mirelatomazini/InstrumentacaoBiomed/instrumentacao_projeto/imagem1_real.jpeg

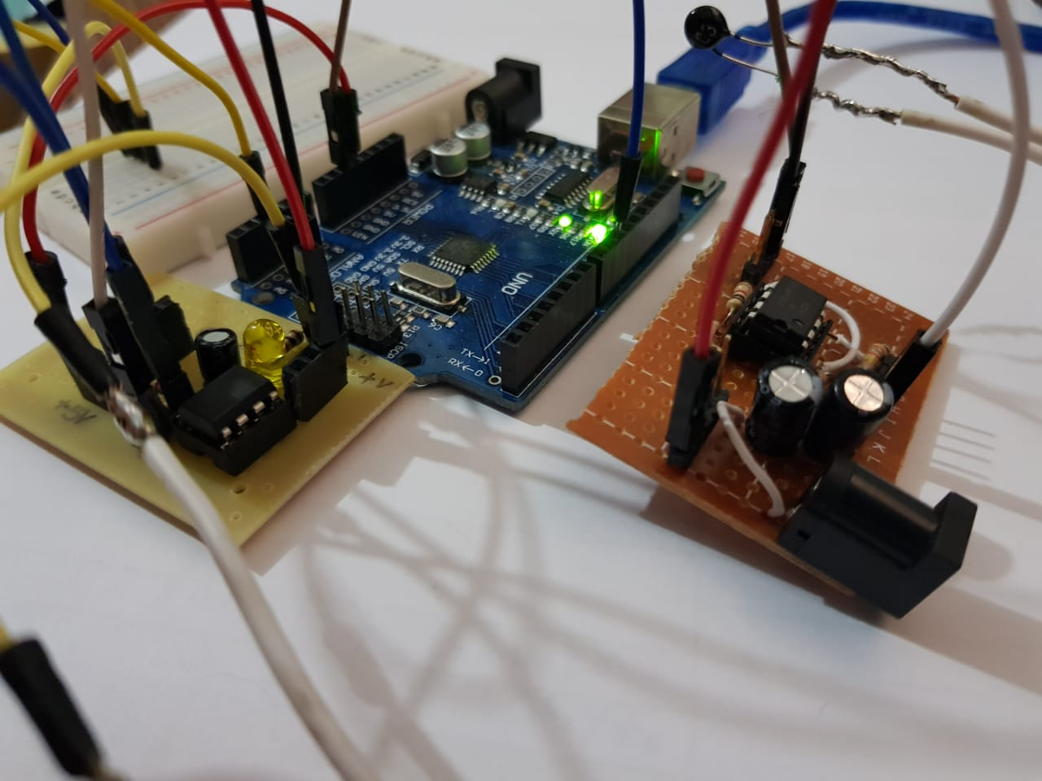
instrumentacao_projeto/imagem1_real.jpeg
