mirelatomazini/InstrumentacaoBiomed/instrumentacao_potenciometro/instrumentacao_potenciometro_plotterserial.jpeg

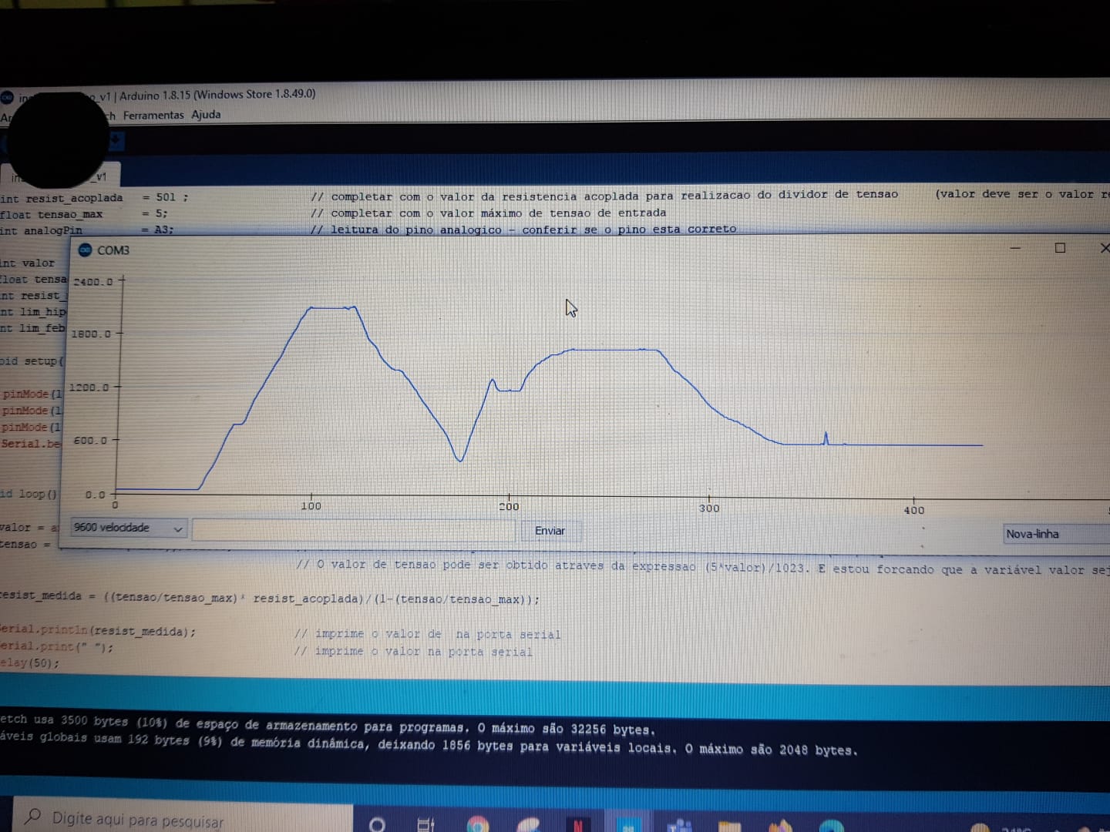
instrumentacao_potenciometro/instrumentacao_potenciometro_plotterserial.jpeg
