mirelatomazini/InstrumentacaoBiomed/instrumentacao_projeto/InstrumentacaoApresentacaoProjeto.pdf

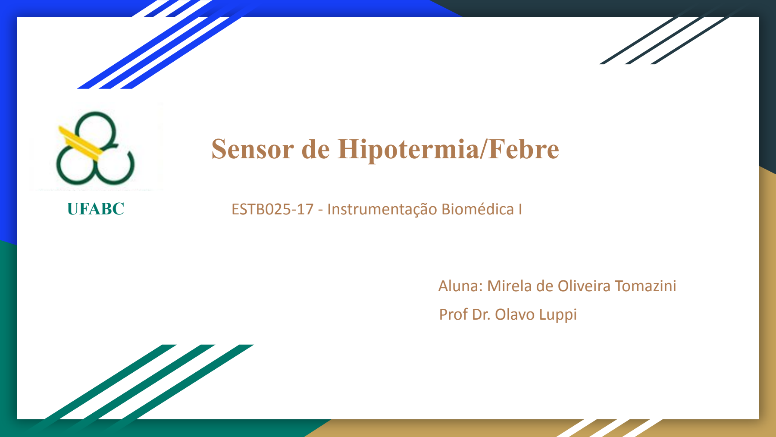
[picture p17: figure]
Sensor de Hipotermia/Febre; Aluna: Mirela de Oliveira Tomazini; ESTB025-17 - Instrumentação Biomédica I; Prof Dr. Olavo Luppi; UFABC

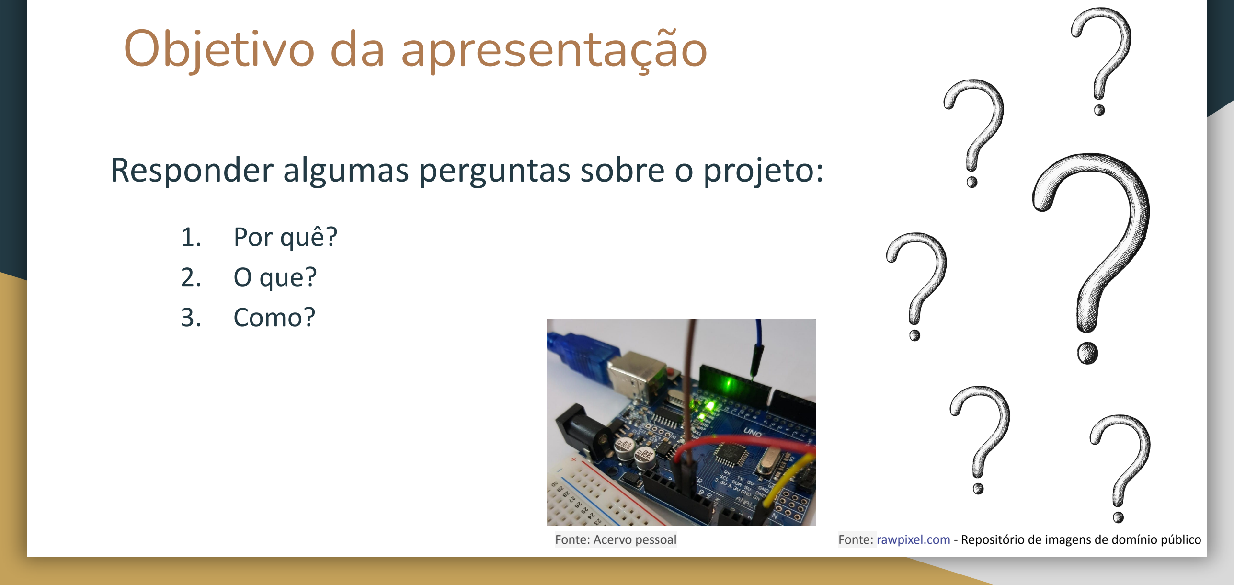
[picture p18: figure]
Objetivo da apresentação; 1. Por quê? 2. O que? 3. Como?

# Responder algumas perguntas sobre o projeto:

Fonte: Acervo pessoal | Fonte: rawpixel.com - Repositório de imagens de domínio público

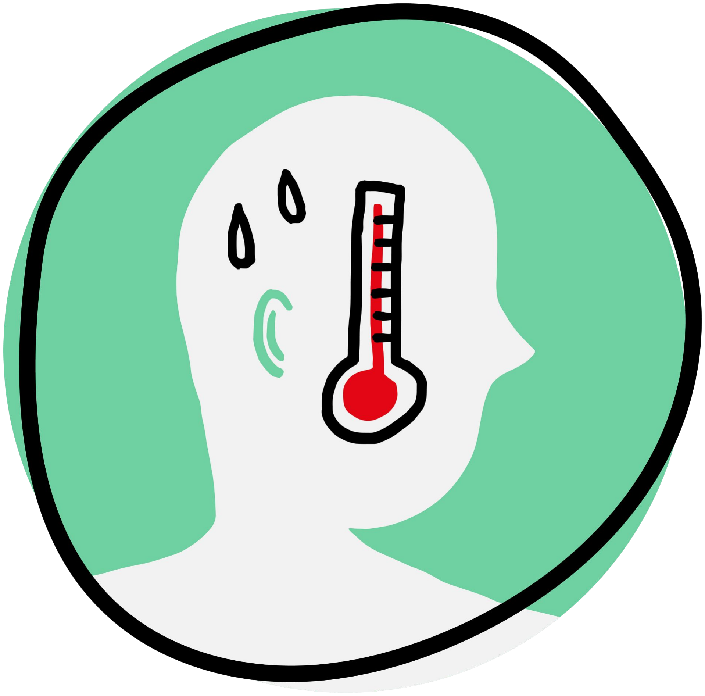
[picture p19: figure]

# Motivação

# - Termorregulação - Manutenção de temperatura corporal

# - Mecanismos de diminuição/aumento de temperatura

# - Importância do monitoramento e manutenção - Pode ser afetada por

# - Anestesia - Acometimento patologias

# - Febre - Hipotermia

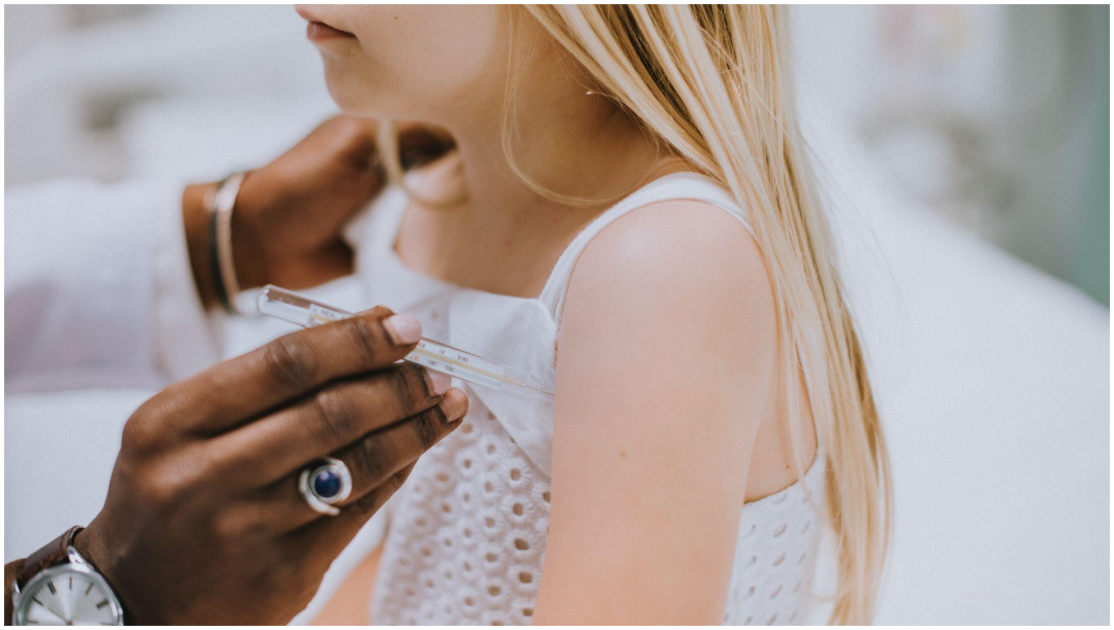
[picture p20: figure]

Fonte: rawpixel.com - Repositório de imagens de domínio público

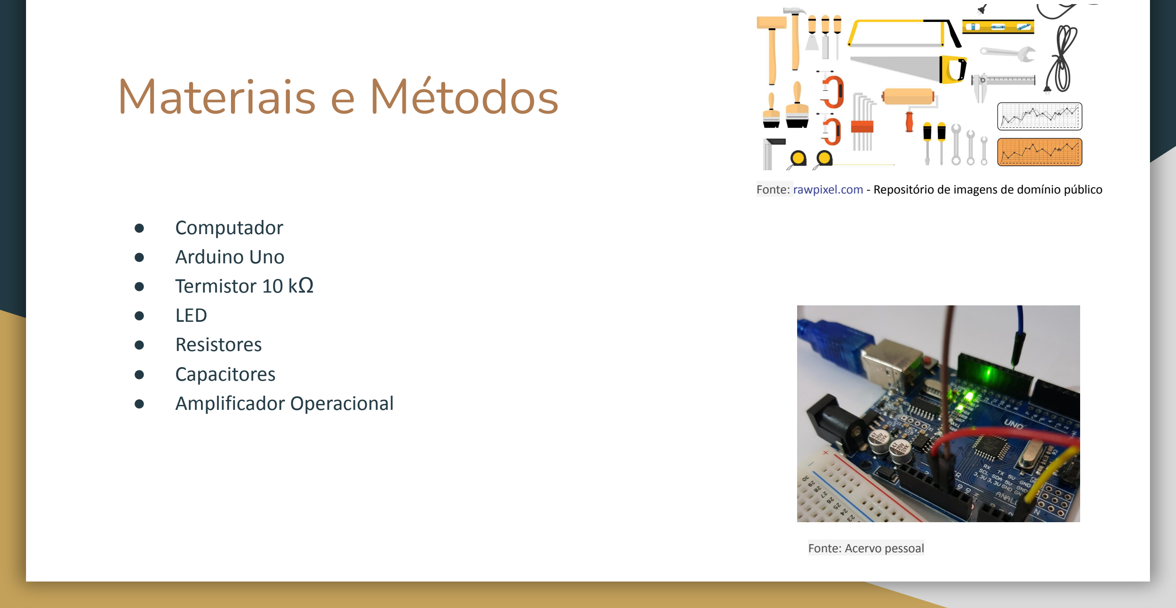
[picture p21: figure]
Materiais e Métodos; ● Computador ● Arduino Uno ● Termistor 10 kΩ ● LED ● Resistores ● Capacitores ● Amplificador Operacional; Fonte: Acervo pessoal

Fonte: rawpixel.com - Repositório de imagens de domínio público

# Desenvolvimento

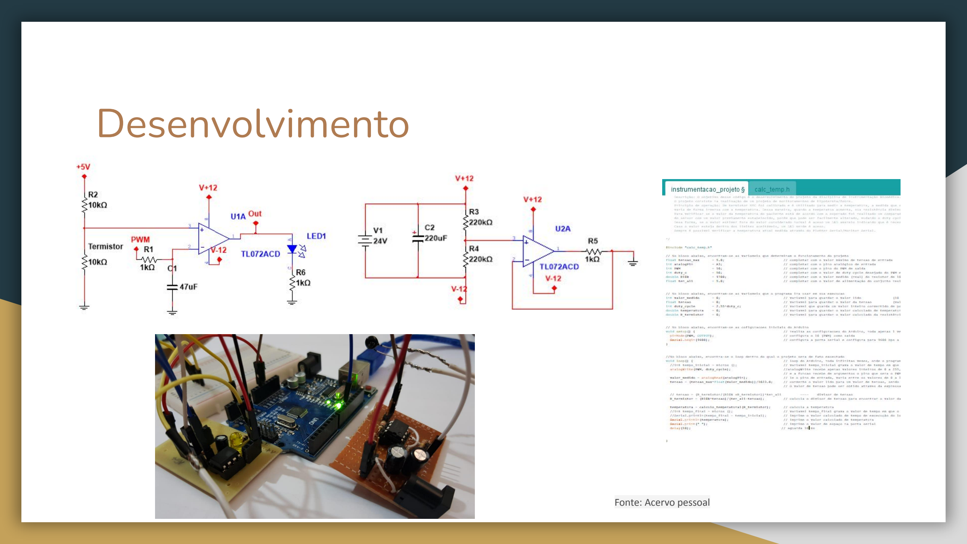
[picture p22: page 5]

Fonte: Acervo pessoal

# Vídeo de apresentação do projeto

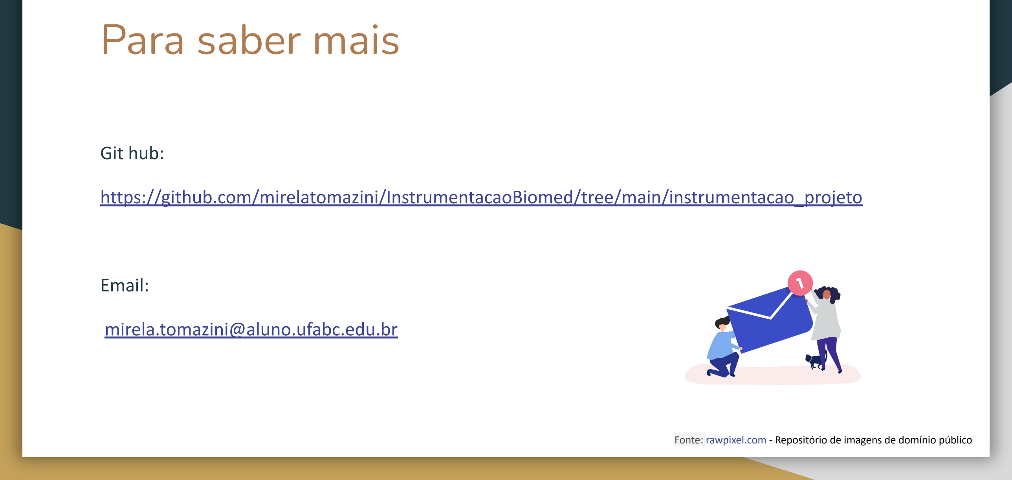
[picture p23: figure]
Para saber mais; Git hub:; Email:; mirela.tomazini@aluno.ufabc.edu.br

# https://github.com/mirelatomazini/InstrumentacaoBiomed/tree/main/instrumentacao_projeto

Fonte: rawpixel.com - Repositório de imagens de domínio público

# Agradecimentos

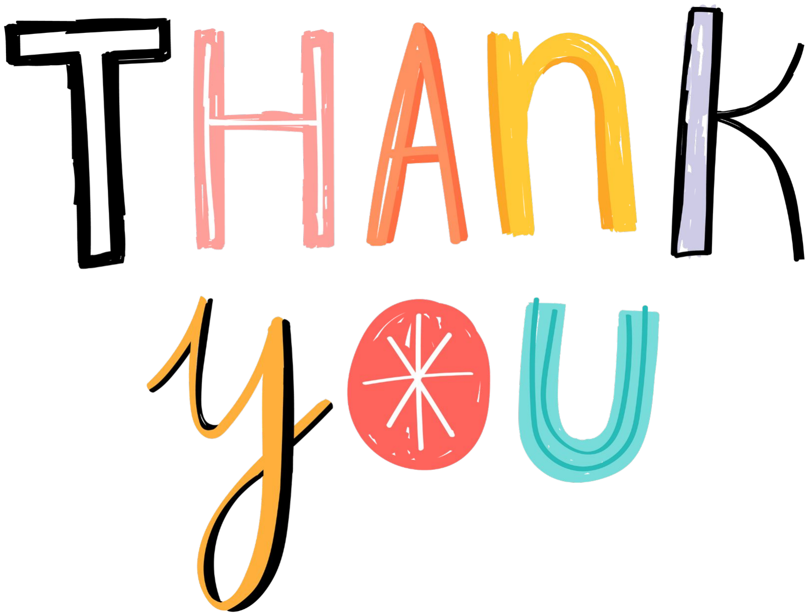
[picture p24: figure]

## - Prof. Dr Olavo Luppi

## - Colegas de turma que cursaram Instrumentação Biomédica I em 2021.Q2

## - Todos que dedicaram um tempo para assistir

Fonte: rawpixel.com - Repositório de imagens de domínio público
