mirelatomazini/InstrumentacaoBiomed/instrumentacao_projeto/calibracao_termistor.xlsx

Sheet: calculos_1
Temperatura ºC | Resistência medida (ohm) | Rref | ln(R/Rref) | ln²(R/Rref) | ln³(R/Rref) | T | T*ln(R/Rref) | T*ln²(R/Rref) | T*ln³(R/Rref)
0 | 33000 | 10000 | 1.193922468 | 1.425450861 | 1.70187781 | 273.15 | 326.1199223 | 389.3619026 | 464.8679239
17.5 | 14760 | 10000 | 0.3893357262 | 0.1515823077 | 0.05901640784 | 290.65 | 113.1604288 | 44.05739773 | 17.15311894
25 | 10050 | 10000 | 0.004987541511 | 2.487557032e-05 | 1.240679396e-07 | 298.15 | 1.487035502 | 0.007416651292 | 3.699085619e-05
27 | 9020 | 10000 | -0.1031407589 | 0.01063801615 | -0.001097213059 | 300.15 | -30.95769879 | 3.193000548 | -0.3293284997
29 | 8250 | 10000 | -0.1923718926 | 0.03700694508 | -0.007119096066 | 302.15 | -58.12516736 | 11.18164846 | -2.151034876
31 | 7740 | 10000 | -0.2561834054 | 0.0656299372 | -0.01681330081 | 304.15 | -77.91818275 | 19.9613454 | -5.113765441
32.2 | 7520 | 10000 | -0.285018955 | 0.08123580473 | -0.02315374417 | 305.35 | -87.03053792 | 24.80535297 | -7.069995784
32.6 | 7390 | 10000 | -0.302457358 | 0.09148045343 | -0.02766893626 | 305.75 | -92.47633722 | 27.97014864 | -8.45977726
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
