mirelatomazini/InstrumentacaoBiomed/(list of files, drawings)

Other design files:
instrumentacao_projeto/InstBiom_SimProjet.ms14
instrumentacao_projeto/InstBiom_SimProjetvs2.ms14
