mirelatomazini/InstrumentacaoBiomed/(commit log)

2021-07-18 arquivos referentes ao teste do arduino utilizando potenciometro
2021-07-19 Atualizacao de um comentario do codigo e adicao do segundo codigo desenvolvido para aprendizagem
2021-08-17 Adicao da simulacao do circuito do projeto
    [InstBiom_SimProjet.ms14]
2021-08-18 ajustes no codigo e adicao do excel
    Codigo salva, compila e foi testado no Arduino, funciona. Excel contem os dados coletados nas medicoes
    [calibracao_termistor.xlsx]
2021-08-18 envio de imagens utilizadas bem como a apresentacao em pdf e mp4
    https://youtu.be/ELi63xAKNg8
    Video de apresentacao do projeto
2021-08-19 ajuste do valor de duty cycle para hipotermia
2021-08-19 adicao do pdf do relatorio apresentado e do circuito simulado
    [InstBiom_SimProjetvs2.ms14]
